ngominhchau24/softmax_proj/docs/figures/smx_exp2.pdf

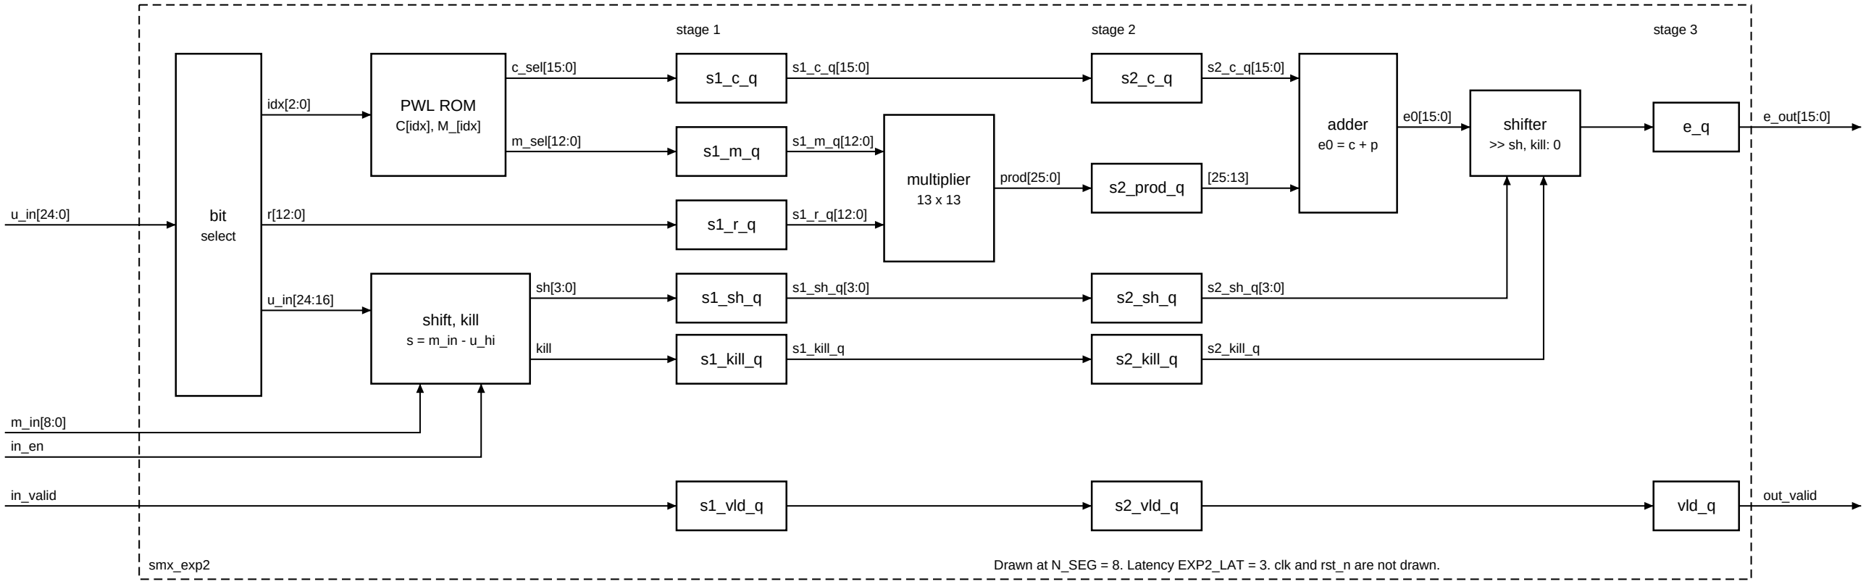
[picture p1: figure]
smx_exp2; stage 1; stage 2; stage 3; bit select; PWL ROM C[idx], M_[idx]; shift, kill s = m_in - u_hi; s1_kill_q; multiplier; s2_prod_q; s2_kill_q; adder e0 = c + p; shifter >> sh, kill: 0; s1_vld_q; s2_vld_q; vld_q; idx[2:0]; c_sel[15:0]; m_sel[12:0]; kill; prod[25:0]; e_out[15:0]; in_valid; out_valid

Drawn at N_SEG = 8. Latency EXP2_LAT = 3. clk and rst_n are not drawn.
