ngominhchau24/softmax_proj/docs/figures/smx_sumacc.pdf

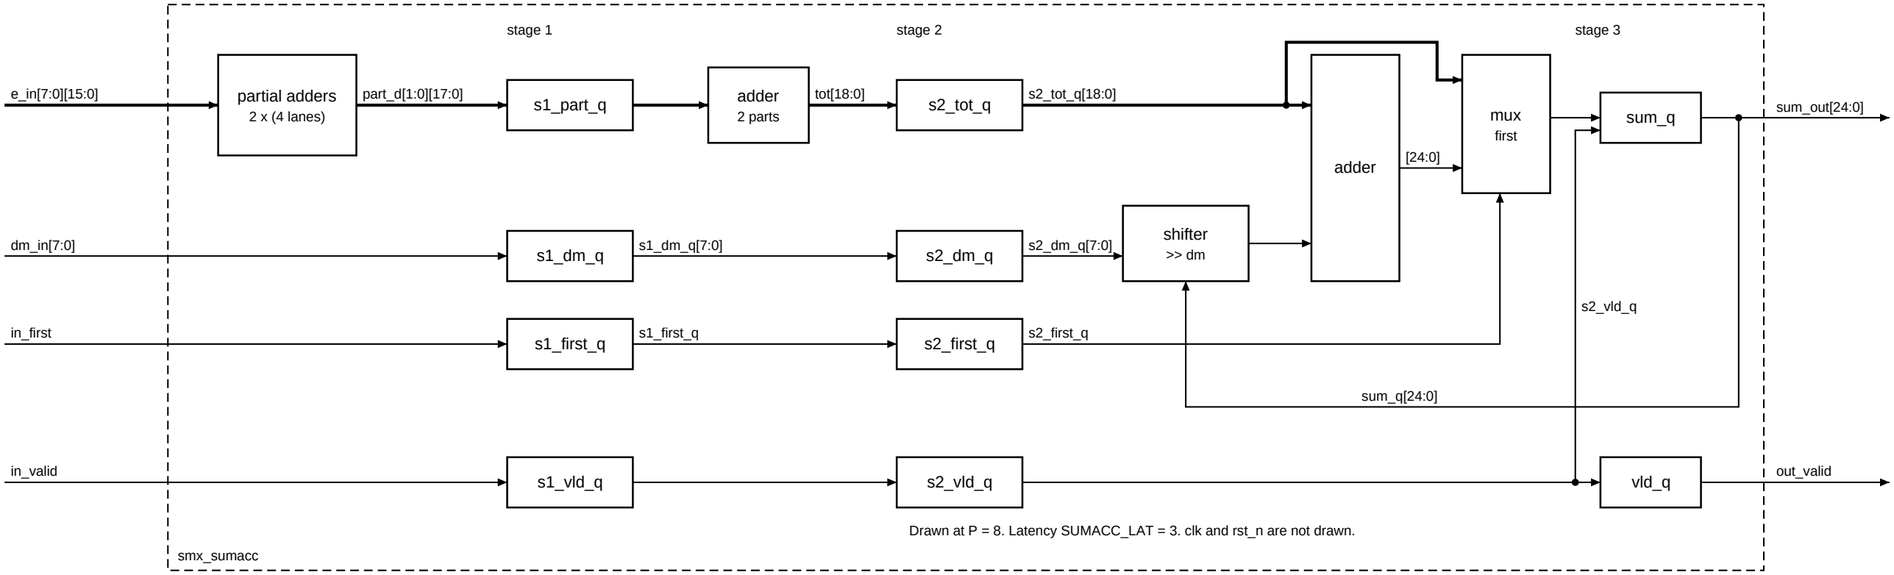
[picture p2: figure]
smx_sumacc; stage 1; stage 2; stage 3; partial adders; 2 x (4 lanes); s1_part_q; s1_first_q; adder; 2 parts; s2_tot_q; s2_first_q; shifter >> dm; mux first; sum_q; s1_vld_q; s2_vld_q; vld_q; part_d[1:0][17:0]; tot[18:0]; in_first; s2_tot_q[18:0]; sum_out[24:0]; sum_q[24:0]; in_valid; out_valid

Drawn at P = 8. Latency SUMACC_LAT = 3. clk and rst_n are not drawn.
