ngominhchau24/softmax_proj/docs/figures/smx_system.pdf

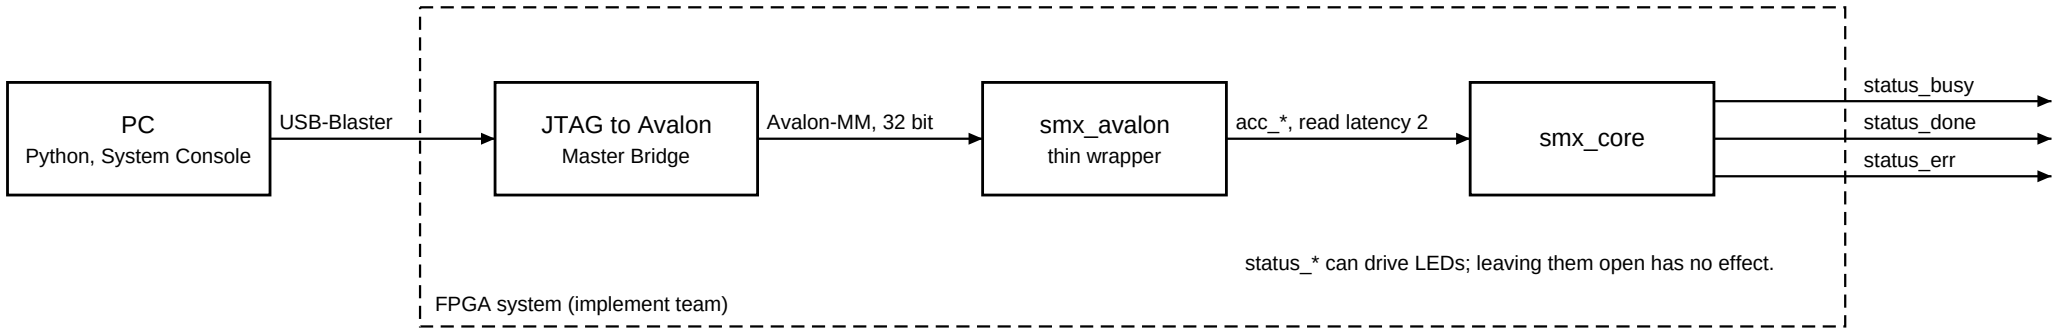
[picture p3: figure]
FPGA system (implement team); PC Python, System Console; JTAG to Avalon Master Bridge; smx_avalon; thin wrapper; smx_core; status_busy; status_done; status_err

USB-Blaster | Avalon-MM, 32 bit | acc_*, read latency 2

status_* can drive LEDs; leaving them open has no effect.
