ngominhchau24/softmax_proj/docs/report/main.tex

% Báo cáo BTL — smx: Integer-Only Softmax Accelerator
% Biên dịch bằng XeLaTeX (hỗ trợ tiếng Việt và font Times New Roman):
%   cd docs/report && xelatex main.tex && xelatex main.tex

\documentclass[12pt,a4paper]{article}

% ---------- Lề trang ----------
\usepackage[left=3cm,right=2cm,top=2.5cm,bottom=2.5cm]{geometry}

% ---------- Font: Times New Roman (fallback Liberation Serif, cùng metric) ----------
\usepackage{fontspec}
\IfFontExistsTF{Times New Roman}
  {\setmainfont{Times New Roman}}
  {\setmainfont{Liberation Serif}}

% ---------- Cỡ chữ 13pt (class article không có sẵn 13pt) ----------
\makeatletter
\renewcommand\normalsize{%
  \@setfontsize\normalsize{13pt}{16pt}%
  \abovedisplayskip=11pt plus 2pt minus 4pt
  \belowdisplayskip=\abovedisplayskip
}
\makeatother
\normalsize

% ---------- Giãn dòng 1.5, đoạn: before 6pt, after 0 ----------
\usepackage{setspace}
\onehalfspacing
\setlength{\parskip}{6pt}
\setlength{\parindent}{1.25cm}

% ---------- Tiện ích ----------
\usepackage{amsmath}
\usepackage{graphicx}
\graphicspath{{../figures/}}
\usepackage{booktabs}
\usepackage{listings}
\lstset{basicstyle=\ttfamily\scriptsize, breaklines=true, breakatwhitespace=true,
        columns=fullflexible, keepspaces=true, frame=single, framesep=4pt,
        xleftmargin=4pt, xrightmargin=4pt, aboveskip=8pt, belowskip=4pt}
% Nhật ký của một testcase: chỉ chèn khi file có trong docs/report/logs/
\newcommand{\smxlog}[2]{\IfFileExists{logs/#1}{\noindent\textit{#2}\lstinputlisting{logs/#1}}{}}
\usepackage{titlesec}
\usepackage{enumitem}
\setlist{itemsep=1pt, parsep=0pt, topsep=3pt, partopsep=0pt}   % danh sách gọn, không cách dòng thừa

% ---------- Hình và bảng trôi ----------
% Cho phép hình, bảng chiếm phần lớn một trang có chữ, để không bị đẩy sang trang riêng gần trống;
% trên trang chỉ có hình thì xếp từ đầu trang xuống, không giãn đều ra cả trang.
\renewcommand{\topfraction}{0.9}
\renewcommand{\bottomfraction}{0.8}
\renewcommand{\textfraction}{0.08}
\renewcommand{\floatpagefraction}{0.8}
\setcounter{topnumber}{3}
\setcounter{bottomnumber}{2}
\setcounter{totalnumber}{4}
\makeatletter
\setlength{\@fptop}{0pt}
\setlength{\@fpsep}{14pt}
\setlength{\@fpbot}{0pt plus 1fil}
\makeatother
\usepackage{hyperref}
\hypersetup{hidelinks}   % liên kết vẫn bấm được, không có khung màu quanh chữ

% ---------- Ngôn ngữ của các nhãn tự sinh ----------
% Báo cáo tiếng Việt: giữ \reportvitrue (Bảng, Hình, Mục lục, Tài liệu tham khảo, Chương).
% Bản tiếng Anh: đổi thành \reportvifalse (Table, Figure, Contents, References, Chapter).
\newif\ifreportvi
\reportvitrue
\ifreportvi
  \renewcommand{\tablename}{Bảng}
  \renewcommand{\figurename}{Hình}
  \renewcommand{\contentsname}{Mục lục}
  \renewcommand{\refname}{Tài liệu tham khảo}
  \newcommand{\smxchaptername}{Chương}
\else
  \newcommand{\smxchaptername}{Chapter}
\fi

% Tiêu đề chương (\section) và mục (\subsection)
\titleformat{\section}
  {\normalfont\bfseries\fontsize{13pt}{16pt}\selectfont\centering}
  {\smxchaptername{} \thesection.}{0.5em}{\MakeUppercase}
\titleformat{\subsection}
  {\normalfont\bfseries\fontsize{13pt}{16pt}\selectfont}
  {\thesubsection}{0.5em}{}
% Mỗi chương bắt đầu ở một trang mới
\newcommand{\sectionbreak}{\clearpage}
\titlespacing*{\section}{0pt}{0pt}{14pt}
\titlespacing*{\subsection}{0pt}{6pt}{0pt}

\begin{document}

% ---------- Trang bìa ----------
\begin{titlepage}
\begin{center}
ĐẠI HỌC QUỐC GIA THÀNH PHỐ HỒ CHÍ MINH\\[0.2em]
\textbf{TRƯỜNG ĐẠI HỌC BÁCH KHOA}\\[2em]
% Logo trường: đặt file docs/figures/logo_bk.png; chưa có file thì trang bìa vẫn biên dịch được
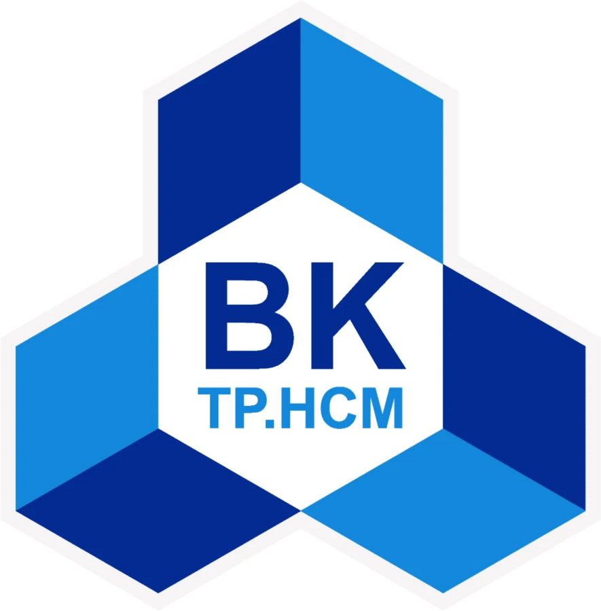
[picture p4: docs/figures/logo_bk.png]
\IfFileExists{../figures/logo_bk.png}{\\[2em]}{\vspace*{3em}}
\textbf{BÁO CÁO BÀI TẬP LỚN}\\[0.3em]
Môn: Cấu trúc phần cứng cho giải thuật học máy\\[2.5em]
\textbf{THIẾT KẾ VÀ HIỆN THỰC FPGA\\BỘ TĂNG TỐC SOFTMAX NGUYÊN THUẦN\\CHO ATTENTION TRANSFORMER}\\[0.3em]
\textit{Design and FPGA Implementation of an\\Integer-Only Softmax Accelerator for Transformer Attention}\\[3em]
Nhóm 6\\[0.6em]
\begin{tabular}{ll}
\toprule
Họ và tên & MSSV \\
\midrule
Ngô Minh Châu     & 2470212 \\
Trần Gia Tuấn     & 2470214 \\
Đặng Phước Tiến   & 2470455 \\
\bottomrule
\end{tabular}\\[2em]
Giảng viên hướng dẫn: PGS.TS. Trương Quang Vinh\\
\vfill
Thành phố Hồ Chí Minh, 2026
\end{center}
\end{titlepage}

% Mục lục: giãn dòng đơn và không cách đoạn, để không tràn trang
{\setlength{\parskip}{0pt}\singlespacing\tableofcontents}
\clearpage

\input{chapters/01-gioi-thieu}
\input{chapters/02-co-so-khao-sat}
\input{chapters/03-dac-ta-so-hoc}
\input{chapters/04-kien-truc}
\input{chapters/05-thiet-ke-khoi}
\input{chapters/06-kiem-thu}
\input{chapters/07-tong-hop-danh-gia}
\input{chapters/08-ket-luan}

\input{chapters/99-tai-lieu-tham-khao}

\end{document}
