ngominhchau24/softmax_proj/docs/spec/07-open-decisions.md

# Open decisions — danh sách để Chau xem

> Ghi trong lúc xây các block còn lại theo ủy quyền của Chau ngày 2026-11-03. Phần A cần Chau quyết. Phần B là việc đã tự quyết để không dừng công việc, đảo ngược được; Chau chỉ cần xem lướt và phản đối nếu không đồng ý.

## A. Cần Chau quyết

- [ ] **A1. Duyệt tài liệu block.** Theo yêu cầu của Chau, RTL được viết trước cổng duyệt. Các block mới không mang trạng thái `APPROVED`; tài liệu ghi "chưa Chau duyệt". Chau đọc rồi xác nhận từng block hoặc yêu cầu sửa.
- [x] **A2. Bộ đồng bộ reset (REQ-IF-04).** Chau chốt 2026-11-05: phần deassert do test drive. Lõi không chứa bộ đồng bộ; bên lái `rst_n` phải thả reset đồng bộ. Mọi testbench trong `tb/` đã thả ở cạnh xuống của `clk`, cách cạnh lên kế tiếp nửa chu kỳ. Khi lõi nằm trong hệ thống thật, phần này thuộc về bên nối `rst_n` (`08-integration-notes.md` mục 2).
- [x] **A3. Sửa câu trong REQ-ARI-05 (requirements đóng băng).** Câu "`sum` không dấu, ≥ 25 bit (≤ 512·2¹⁶)" có cận 2²⁵, cần 26 bit. Cận đúng và đã đo là `L_MAX·2¹⁵ = 2²⁴`, cần 25 bit. Không ảnh hưởng số học hay giao diện. Chau duyệt 2026-11-06; đã sửa `requirements.md` thành "≤ 512·2¹⁵ = 2²⁴", ghi Nhật ký và mục 7.1 của `PROJECT.md`.
- [ ] **A4. Span Platform Designer (bàn giao nhóm implement, chưa kiểm).** Cổng 13 bit word address có thể khiến Platform Designer gán span 0x8000 thay vì 0x6000 trong requirements 5.2. Lõi không bị ảnh hưởng vì vùng `0x1800..0x1FFF` đọc 0. Đề xuất ghi một dòng vào `08-integration-notes.md` để nhóm implement kiểm.

- [ ] **A5. Sideband trong M10K, đường găng nhất ở P = 8.** Quartus tự chuyển `tag_q` và trễ `u` sang `altshift_taps`, tiết kiệm thanh ghi nhưng ngõ ra RAM chậm. Mọi seed vẫn đạt ≥ 100 MHz nên không bắt buộc sửa. So sánh bằng Fitter thật, cùng 3 seed, Fmax lấy góc slow xấu hơn:

  | Cấu hình | Fmax seed 1 / 2 / 3 (MHz) | Thanh ghi | M10K | ALM |
  |---|---|---|---|---|
  | P = 8, hiện tại | 122,09 / 129,87 / 134,41 | ~1 210 | 21 | ~1 035 |
  | P = 8, `AUTO_SHIFT_REGISTER_RECOGNITION OFF` | 124,38 / 139,63 / 128,29 | ~1 810 | 15 | ~1 023 |
  | P = 16, hiện tại | 108,57 / 112,94 / 107,83 | ~2 020 | 33 | ~1 817 |
  | P = 16, `AUTO_SHIFT_REGISTER_RECOGNITION OFF` | 108,93 / 111,31 / 112,93 | ~3 190 | 23 | ~1 795 |

  Chênh lệch nằm trong sai số giữa các seed. Đề xuất giữ nguyên, không thêm attribute: không có lợi Fmax rõ ràng, và đường `s3_c_q` → `smx_maxtree.s1_a_q` vẫn còn đó khi bỏ M10K. Nếu sau này cần thêm biên ở P = 16, chỗ cần sửa là tầng 1 của `smx_maxtree`, không phải sideband.
- [ ] **A6. Giá trị vượt độ rộng trường của LEN, ROWS.** Ghi LEN = 1025 cho `len = 1` (trường [9:0]), ghi ROWS = 33 cho `rows = 1` (trường [4:0]); lần chạy diễn ra bình thường, không có ERR. Đúng theo bản đồ thanh ghi, nhưng phần mềm có thể tưởng ERR bắt được mọi giá trị sai. Đề xuất giữ RTL, ghi một dòng vào `08-integration-notes.md`.
- [ ] **A7. Đường `acc_*` chưa được ràng buộc timing (bàn giao nhóm implement).** SDC của `syn/fit.sh` chỉ có clock, nên Fmax là thanh ghi tới thanh ghi. Đo thử bằng `quartus_sta` với input delay 0, góc slow 0 °C, seed 1: `acc_addr` → thanh ghi còn slack 7,85 / 4,43 / 7,42 ns (P = 4/8/16), đường dài nhất qua decode vào `s1_val_q`, `k_q`; `rd_q` → `acc_readdata` 4,65 / 3,86 / 4,24 ns; recovery của `rst_n` 7,82 / 8,21 / 8,30 ns. Các đường này Fitter không tối ưu, nên số chỉ để tham khảo; nhóm implement sẽ có số thật khi tổng hợp cả hệ thống. Đề xuất ghi vào `08-integration-notes.md`: ở 100 MHz, interconnect còn khoảng 4 ns cho `acc_addr`, và nên ràng buộc đường này khi tổng hợp.

## B. Đã tự quyết (đảo ngược được)

- **B1.** `SUM_W` từ 26 xuống 25. `E ≤ 2¹⁵` nên `sum ≤ L_MAX·2¹⁵ = 2²⁴`; đạt 2²⁴ ở `K = 0, L = 512` [GM]. Requirements chỉ đòi ≥ 25 bit.
- **B2.** Kiểm LEN, ROWS nằm ở `smx_csr`, không có trạng thái CHECK trong FSM. START sai thì BUSY không lên và `CYCLE_CNT = 0`. Sơ đồ FSM trong `04-architecture.md` được cập nhật theo; bảng block ở đó vốn đã ghi việc kiểm thuộc `smx_csr`.
- **B3.** Khi BUSY, ghi LEN, ROWS, SCALE_K, X_BUF bị bỏ qua. REQ-IF-09 để không xác định nên được phép chọn.
- **B4.** `smx_buf` có `BANKS = P/4` để quét được P = 4/8/16 (A5). P = 8 đúng bằng A1.
- **B5.** Latency chốt ở `smx_pkg`, `T_row = 2G + 54`, `CYCLE_CNT = R·(2G + 54) + 1`. Là số thiết kế; xác nhận bằng mô phỏng ở bước tích hợp.
- **B6.** `model/softmax_ref.py` thêm trường trung gian vào `info` và tách `group_sum`, `reciprocal`, `norm_out`. Không đổi số học: 6000 hàng ngẫu nhiên và corner ở P, N_SEG = 4/8/16 cho kết quả trùng bản cũ.
- **B7.** Bộ chia dùng so sánh 25 bit và 27 vòng lặp, thay vì ~41 bit như bảng ước lượng trong `04-architecture.md`. Kết quả vẫn bit-exact vì `2¹⁴ ≤ sum ≤ 2²⁴`.
- **B8.** Chia tầng `smx_maxtree` để tầng 2 chứa mức cuối của cây, so với M và `dm`. Kết quả từ Fitter trên probe: gom cả cây vào tầng 1 chỉ đạt 90 MHz ở P = 16.
- **B9.** `smx_delay` không có tài liệu block và testbench riêng vì chỉ vài dòng; kiểm qua testbench `smx_core`.
- **B10.** Dạng assertion REQ-VER-03 cho nhóm verify: `$rose(done) |-> !busy`, không phải `|-> $fell(busy)`; assertion "không có X trên `readdata`" chỉ áp dụng cho vị trí đã ghi (`05-cross-block.md` mục 4.8).
- **B11.** `tb_smx_core` có một bộ đếm thụ động nhìn vào `dut.u_ybuf.wr_en`, ngoại lệ duy nhất với nguyên tắc chỉ dùng `acc_*`. Lý do: START ngay chu kỳ DONE cùng cấu hình cho Y giống hệt, nên mất ghi không thể thấy qua bus.
