ngominhchau24/softmax_proj/docs/report/chapters/04-kien-truc.tex

\section{Kiến trúc hệ thống}

\subsection{Sơ đồ tổng thể}

Bộ tăng tốc gồm một lõi \texttt{smx\_core} và một lớp bao Avalon-MM mỏng. Lõi chứa toàn bộ thanh ghi điều khiển, bộ đệm đầu vào X, bộ đệm đầu ra Y, bộ điều khiển và datapath. Lõi đưa ra một cổng truy cập bộ nhớ đơn giản \texttt{acc\_*}, có độ trễ đọc cố định 2 chu kỳ và không có tín hiệu chờ. Ranh giới này trong hệ thống demo đã được vẽ ở Hình \ref{fig:smx-system} của Chương 1: máy tính điều khiển qua USB-Blaster, cầu JTAG to Avalon Master, lớp bao rồi tới lõi.

Hình \ref{fig:softmax-flow} tóm tắt đường đi của dữ liệu qua các phép tính của Chương 3. Luồng dữ liệu của một hàng:
\begin{enumerate}
  \item Lượt 1 đọc $X$ theo nhóm $P$ phần tử, đưa qua phép nhân với $K$, IntMax, $E(d)$ và cây cộng để có $\mathit{sum}$ và $M$.
  \item Bộ chia tính $\mathit{Rcp}$ từ $\mathit{sum}$.
  \item Lượt 2 đọc lại $X$, tính lại $E$, nhân với $\mathit{Rcp}$, làm tròn, bão hoà và ghi vào $Y$.
\end{enumerate}

\begin{figure}[htbp]
  \centering
  
  \caption{Luồng số học của một hàng. Lượt 1 đi qua nhánh $M$, $dM$ và bộ tích luỹ $\mathit{sum}$ để có $\mathit{Rcp}$; lượt 2 dùng lại nhánh $E$ rồi nhân với $\mathit{Rcp}$ để ra $y$.}
  \label{fig:softmax-flow}
\end{figure}

\subsection{Cấu trúc bên trong lõi}

Hình \ref{fig:smx-core} là sơ đồ khối của \texttt{smx\_core}, vẽ ở $P = 8$ và $N_{\text{SEG}} = 8$. Khối \texttt{smx\_csr} giải mã cổng \texttt{acc\_*}, giữ các thanh ghi và ghi vào X\_BUF. Khi chạy, \texttt{smx\_ctrl} phát địa chỉ từng nhóm; dữ liệu đọc từ X\_BUF đi qua \texttt{smx\_scale}, \texttt{smx\_maxtree} và \texttt{smx\_exp2}, rồi rẽ sang \texttt{smx\_sumacc} và \texttt{smx\_divider} ở lượt 1, hoặc sang \texttt{smx\_norm} và Y\_BUF ở lượt 2. Một chuỗi thanh ghi dịch mang các nhãn của nhóm (lượt, nhóm đầu, nhóm cuối, mặt nạ lane) đi song song với dữ liệu, nên mỗi khối biết nhóm nó đang xử lý mà không cần tự đếm.

\begin{figure}[p]
  \centering
  
  \caption{Sơ đồ khối bên trong \texttt{smx\_core} (xoay ngang), vẽ ở $P = 8$, $N_{\text{SEG}} = 8$; clock và reset không vẽ.}
  \label{fig:smx-core}
\end{figure}

\subsection{Điều khiển}

Khối \texttt{smx\_ctrl} đi theo máy trạng thái ở Hình \ref{fig:smx-fsm}, gồm tám trạng thái. Từ \texttt{IDLE}, lệnh START đưa lõi vào \texttt{P1\_RUN}, nơi mỗi chu kỳ phát một nhóm của lượt 1; \texttt{P1\_DRAIN} chờ tổng của nhóm cuối ra khỏi pipeline. \texttt{DIV} khởi động bộ chia và \texttt{DIV\_WAIT} chờ nó xong. \texttt{P2\_RUN} và \texttt{P2\_DRAIN} làm tương tự cho lượt 2, tới khi phần tử $y$ cuối cùng được ghi. \texttt{NEXT\_ROW} hoặc quay lại \texttt{P1\_RUN} cho hàng kế tiếp, hoặc báo xong và về \texttt{IDLE}. Việc chuyển pha dựa trên sự kiện từ datapath, không dựa trên bộ đếm độ trễ.

\begin{figure}[htbp]
  \centering
  
  \caption{Máy trạng thái của \texttt{smx\_ctrl}. Nhãn trên mỗi cung là điều kiện chuyển; $r$ là chỉ số hàng, $R$ là số hàng.}
  \label{fig:smx-fsm}
\end{figure}

\subsection{Giao diện}

IP là một Avalon-MM slave với dữ liệu 32 bit và địa chỉ theo word. Giao diện không dùng burst, không dùng \texttt{waitrequest}, và có độ trễ đọc 2 chu kỳ. Phần mềm thăm dò bit \texttt{DONE} để biết khi nào xong; IP không phát ngắt. Ba tín hiệu trạng thái \texttt{status\_busy}, \texttt{status\_done} và \texttt{status\_err} được đưa ra ngoài qua một conduit để nối LED khi demo.

Hai kiểu hệ thống được hỗ trợ:
\begin{itemize}
  \item Đường demo chính: không dùng HPS, master là JTAG to Avalon Master Bridge, điều khiển từ PC bằng System Console.
  \item Đường tuỳ chọn: GHRD Terasic, master là cầu HPS-to-FPGA.
\end{itemize}

\subsection{Lớp bao Avalon và hệ thống demo}

Lớp bao \texttt{smx\_avalon} chỉ đổi tên tín hiệu giữa Avalon-MM slave \texttt{s0} và cổng \texttt{acc\_*} của lõi, không thêm logic nào. Thành phần Platform Designer được khai báo trong \texttt{ip/smx\_hw.tcl} với các giao diện: clock, reset mức thấp, slave \texttt{s0} (địa chỉ theo word, độ trễ đọc 2, không \texttt{waitrequest}, không burst, \texttt{byteenable} 4 bit) và conduit trạng thái. Hai tham số $P$ và $N_{\text{SEG}}$ chọn được khi tạo thành phần.

Hệ thống demo trên DE10-Standard không dùng HPS và gồm ba khối: nguồn clock 50 MHz từ \texttt{CLOCK\_50}, JTAG to Avalon Master Bridge, và \texttt{smx} đặt ở địa chỉ gốc 0, nên offset dùng trong System Console trùng với offset của bản đồ thanh ghi. Ở mức top, nút \texttt{KEY[0]} là reset mức thấp, đi qua một bộ đồng bộ hai tầng để được thả đồng bộ với clock, vì lõi không có bộ đồng bộ reset riêng; ba đèn \texttt{LEDR[2:0]} hiển thị BUSY, DONE và ERR.

Tại thời điểm viết báo cáo, lớp bao, thành phần và hệ thống demo đã được nhóm hiện thực viết và biên dịch thành công bằng Quartus, tạo được tệp \texttt{.sof}. Thiết kế chưa được nạp lên board, và phần gán chân chưa được đối chiếu với tài liệu của Terasic.

\subsection{Bản đồ thanh ghi}

Bảng \ref{tab:regmap} tóm tắt bản đồ thanh ghi, offset tính theo byte.

\begin{table}[htbp]
\centering
\small
\begin{tabular}{lllp{7.2cm}}
\toprule
Offset & Tên & Truy cập & Nội dung \\
\midrule
0x0000 & CTRL      & W   & Bit 0: START (tự xoá) \\
0x0004 & STATUS    & R   & BUSY, DONE, ERR \\
0x0008 & LEN       & R/W & Độ dài hàng $L$, 1..512 \\
0x000C & ROWS      & R/W & Số hàng $R$, 1..16 \\
0x0010 & SCALE\_K  & R/W & Hệ số $K$ (UQ0.16) \\
0x0014 & CYCLE\_CNT & R  & Số chu kỳ từ START đến DONE \\
0x0018 & HW\_PARAM & R   & $P$, $\log_2 L_{\max}$, $R_{\max}$, $\log_2 N_{\text{SEG}}$, VERSION \\
0x2000--0x3FFF & X\_BUF & R/W & INT8, hàng $r$ phần tử $i$ tại byte $r \cdot 512 + i$ \\
0x4000--0x5FFF & Y\_BUF & R   & UINT8, cùng bố trí \\
\bottomrule
\end{tabular}
\caption{Bản đồ thanh ghi của IP (rút gọn từ đặc tả).}
\label{tab:regmap}
\end{table}

\subsection{Trình tự phần mềm}

Phần mềm thực hiện lần lượt các bước sau: tính $K$ và ghi vào \texttt{SCALE\_K}; ghi $R$ hàng vào X\_BUF; ghi \texttt{LEN} và \texttt{ROWS}; ghi START; đọc STATUS cho đến khi DONE bằng 1; đọc Y\_BUF, và đọc CYCLE\_CNT nếu cần đo thời gian.
