ngominhchau24/softmax_proj/docs/report/chapters/05-thiet-ke-khoi.tex

\section{Thiết kế các khối}

Lõi được chia thành mười khối, thiết kế theo thứ tự phụ thuộc. Mỗi khối có một tài liệu thiết kế riêng, mô tả chức năng, bảng cổng, số học đối chiếu với golden model, sơ đồ cấu trúc, timing và kế hoạch kiểm thử. Trạng thái tại thời điểm viết báo cáo được tóm tắt trong Bảng \ref{tab:blocks}: cả mười khối đã có RTL và testbench tự kiểm, chín khối con đã được tích hợp vào \texttt{smx\_core}.

\begin{table}[htbp]
\centering
\begin{tabular}{clll}
\toprule
\# & Khối & Vai trò & Trạng thái \\
\midrule
1  & \texttt{smx\_exp2}    & $d \to E$, PWL và dịch & Đã tích hợp \\
2  & \texttt{smx\_scale}   & $u = q \cdot K$, $c = \lceil u \rceil$ & Đã tích hợp \\
3  & \texttt{smx\_maxtree} & $M_g$ và cập nhật $M$ & Đã tích hợp \\
4  & \texttt{smx\_sumacc}  & Cây cộng và tích luỹ có dịch & Đã tích hợp \\
5  & \texttt{smx\_divider} & $\lfloor 2^{40} / \mathit{sum} \rfloor$ tuần tự & Đã tích hợp \\
6  & \texttt{smx\_norm}    & $E \cdot \mathit{Rcp}$, làm tròn, bão hoà & Đã tích hợp \\
7  & \texttt{smx\_buf}     & Bộ đệm nhiều bank, có byte-enable & Đã tích hợp \\
8  & \texttt{smx\_csr}     & Thanh ghi, START/DONE/ERR & Đã tích hợp \\
9  & \texttt{smx\_ctrl}    & FSM hàng và lượt & Đã tích hợp \\
10 & \texttt{smx\_core}    & Nối các khối & Mô phỏng đạt \\
\bottomrule
\end{tabular}
\caption{Danh sách khối và trạng thái thiết kế.}
\label{tab:blocks}
\end{table}

\subsection{Khối số học}

Mỗi khối số học là một pipeline có độ trễ cố định. Các khối \texttt{smx\_scale}, \texttt{smx\_exp2} và \texttt{smx\_norm} xử lý một lane và được nhân bản $P$ lần; \texttt{smx\_maxtree}, \texttt{smx\_sumacc} và \texttt{smx\_divider} mỗi khối chỉ có một bản. Ba khối mang ý tưởng chính của thuật toán được vẽ chi tiết ở các Hình \ref{fig:blk-maxtree}, \ref{fig:blk-exp2} và \ref{fig:blk-sumacc}; trong hình, mọi thanh ghi có hậu tố \texttt{\_q}.

Khối \texttt{smx\_scale} nhân $q$ với $K$ bằng một bộ nhân $8 \times 17$ có dấu để có $u$, rồi làm tròn lên để có $c$; độ trễ 3 chu kỳ. Khối \texttt{smx\_maxtree} thực hiện IntMax: nó che các lane nằm ngoài độ dài hàng, tìm giá trị lớn nhất của nhóm, rồi cập nhật $M$ và bước nhảy $dM$. Khối \texttt{smx\_exp2} là khối phức tạp nhất về số học, vì phải khớp bit-exact với bảng PWL và phép dịch. Khối \texttt{smx\_sumacc} cộng $E$ của các lane rồi tích luỹ vào $\mathit{sum}$; vòng phản hồi qua $\mathit{sum}$ là điểm được dự đoán sẽ găng về timing khi thiết kế kiến trúc, nhưng kết quả đo ở Chương 7 cho thấy với $P = 8$ và $P = 16$ đường găng nhất lại nằm ở tầng đầu của cây max trong \texttt{smx\_maxtree}.

Khối \texttt{smx\_divider} là bộ chia phục hồi radix-2, mỗi chu kỳ quyết định một bit thương và mất 28 chu kỳ cho mỗi hàng. Khối \texttt{smx\_norm} nhân $E$ với $\mathit{Rcp}$ bằng một bộ nhân $16 \times 27$, làm tròn ở bit 31 và bão hoà về 255; độ trễ 3 chu kỳ.

\begin{figure}[htbp]
  \centering
  
  \caption{\texttt{smx\_maxtree}: che các lane ngoài độ dài hàng, tìm giá trị lớn nhất của nhóm bằng cây so sánh, rồi cập nhật $M$ và bước nhảy $dM$. Độ trễ 2 chu kỳ; vẽ ở $P = 8$.}
  \label{fig:blk-maxtree}
\end{figure}

\begin{figure}[htbp]
  \centering
  
  \caption{\texttt{smx\_exp2}: tính $E = 2^{d}$ với $d = u - M \cdot 2^{16}$. Phần lẻ chọn hệ số trong bảng PWL và qua bộ nhân $13 \times 13$; phần nguyên thành lượng dịch phải, hoặc ép kết quả về 0. Độ trễ 3 chu kỳ; vẽ ở $N_{\text{SEG}} = 8$.}
  \label{fig:blk-exp2}
\end{figure}

\begin{figure}[htbp]
  \centering
  
  \caption{\texttt{smx\_sumacc}: cộng $E$ của $P$ lane bằng cây cộng hai tầng, rồi tích luỹ vào $\mathit{sum}$ sau khi dịch tổng cũ sang phải $dM$ bit; nhóm đầu của hàng bỏ qua tổng cũ. Độ trễ 3 chu kỳ; vẽ ở $P = 8$.}
  \label{fig:blk-sumacc}
\end{figure}

\subsection{Khối lưu trữ và điều khiển}

Hai bộ đệm X và Y dùng chung một module \texttt{smx\_buf}, là bộ nhớ hai cổng đơn có cổng đọc qua thanh ghi. Số bank bằng $P/4$, mỗi bank rộng 32 bit; với $P = 8$, mỗi bộ đệm gồm hai bank 32 bit $\times$ 1024 word, và mỗi byte của mỗi bank là một RAM riêng để ghi theo \texttt{byteenable}. Khối \texttt{smx\_csr} giải mã cổng \texttt{acc\_*}, giữ các thanh ghi điều khiển và trạng thái, và ghép đường đọc có độ trễ 2 chu kỳ. Khối \texttt{smx\_ctrl} điều khiển thứ tự hàng, lượt, địa chỉ và mặt nạ lane cho nhóm cuối của mỗi hàng; máy trạng thái của nó đã được mô tả ở Chương 4.

\subsection{Độ trễ và tài nguyên từng khối}

Bảng \ref{tab:blk-res} ghi độ trễ của từng khối và tài nguyên khi tổng hợp riêng khối đó. Các số tài nguyên lấy từ bước Analysis \& Synthesis của Quartus, chưa qua Fitter, nên chỉ dùng để so sánh tương đối giữa các khối; tài nguyên của cả lõi sau Fitter nằm ở Chương 7. Tổng độ trễ của đường từ địa chỉ đọc X\_BUF tới $E$ là $1 + 3 + 2 + 3 = 9$ chu kỳ, và mỗi lượt quét cộng thêm 3 chu kỳ của \texttt{smx\_sumacc} hoặc \texttt{smx\_norm}.

\begin{table}[htbp]
\centering
\small
\begin{tabular}{llrrrl}
\toprule
Khối & Tổng hợp ở & Độ trễ & ALUT & Thanh ghi & Khác \\
\midrule
\texttt{smx\_scale}   & 1 lane  & 3  & 13  & 85  & 1 DSP \\
\texttt{smx\_maxtree} & $P = 8$ & 2  & 202 & 38  & \\
\texttt{smx\_exp2}    & 1 lane  & 3  & [Chưa đo] & [Chưa đo] & 1 DSP \\
\texttt{smx\_sumacc}  & $P = 8$ & 3  & 180 & 101 & \\
\texttt{smx\_divider} &         & 28 & 60  & 109 & \\
\texttt{smx\_norm}    & 1 lane  & 3  & 20  & 66  & 1 DSP \\
\texttt{smx\_buf}     & $P = 8$ & 1  &     & 0   & 65\,536 bit bộ nhớ khối \\
\texttt{smx\_csr}     & $P = 8$ & 2  & 192 & 136 & độ trễ của đường đọc \\
\texttt{smx\_ctrl}    & $P = 8$ &    & 72  & 24  & ngõ ra tổ hợp \\
\bottomrule
\end{tabular}
\caption{Độ trễ (chu kỳ) và tài nguyên của từng khối sau Analysis \& Synthesis. Ô trống: không áp dụng.}
\label{tab:blk-res}
\end{table}

\subsection{Kết quả thiết kế}

Mỗi khối có testbench tự kiểm, so kết quả bit-exact với vector sinh từ golden model, và đều đạt ở các giá trị $P$ và $N_{\text{SEG}}$ mà khối phụ thuộc. Lõi \texttt{smx\_core} sau tích hợp được kiểm qua cổng \texttt{acc\_*}; kết quả kiểm thử được trình bày ở Chương 6, tài nguyên và tần số sau Fitter ở Chương 7.
