ngominhchau24/softmax_proj/docs/figures/sweep_p.pdf

## Tài nguyên logic

## Fmax theo từng seed (MHz)

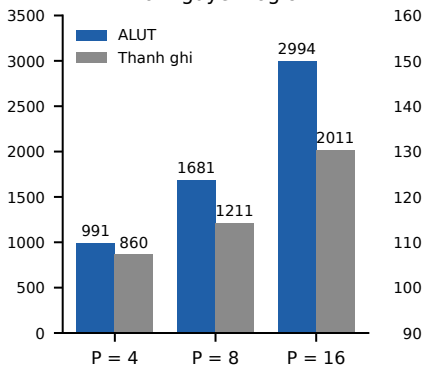
[picture p12: figure]
ALUT Thanh ghi
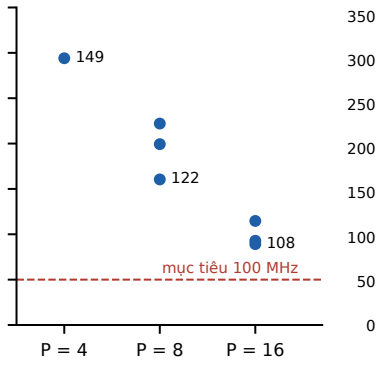
[picture p13: figure]
108 mục tiêu 100 MHz

P = 4 | P = 8 | P = 16

310

182

118

## Chu kỳ mỗi hàng, L = 512
