ngominhchau24/softmax_proj/docs/figures/softmax_flow.pdf

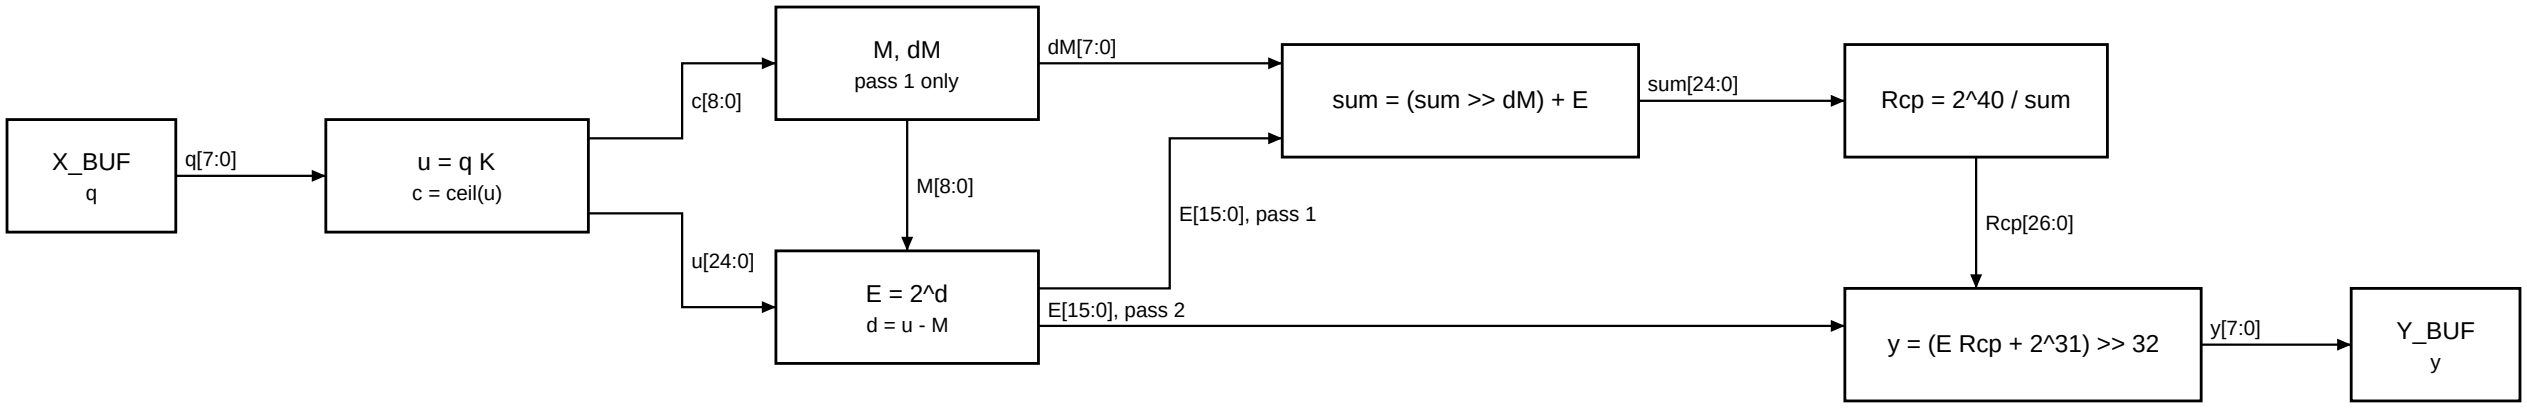
[picture p14: figure]
X_BUF q; u = q K c = ceil(u); M, dM pass 1 only; sum = (sum >> dM) + E; Rcp = 2^40 / sum; y = (E Rcp + 2^31) >> 32; Y_BUF y; E[15:0], pass 1; sum[24:0]; Rcp[26:0]; E[15:0], pass 2
