ngominhchau24/softmax_proj/docs/figures/dv_latency_cycle_cnt.pdf

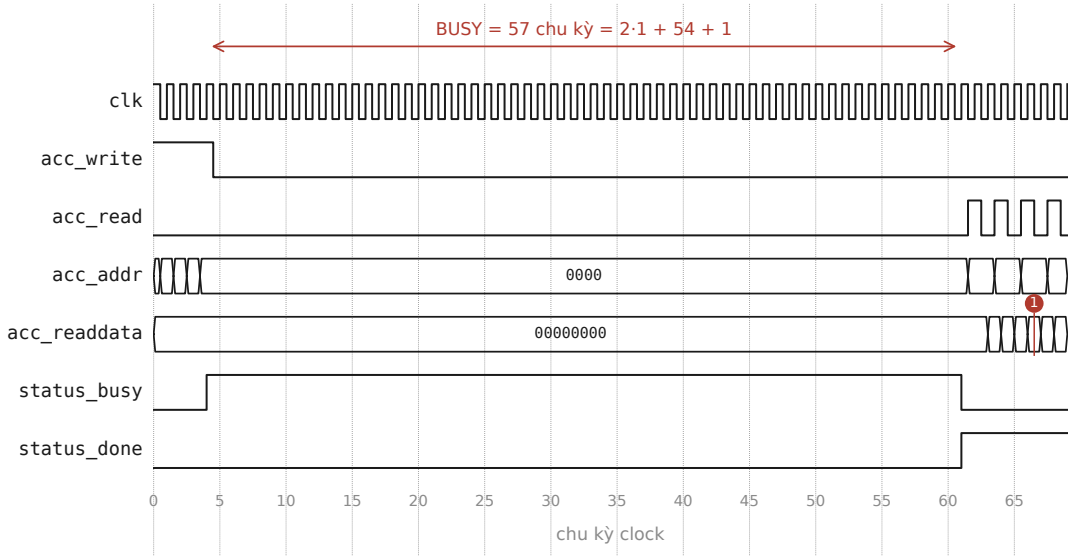
[picture p15: figure]
clk; acc_write; acc_read; acc_addr; acc_readdata; status_busy; status_done; chu kỳ clock; BUSY = 57 chu kỳ = 2·1 + 54 + 1
