ngominhchau24/softmax_proj/docs/figures/dv_proto_err.pdf

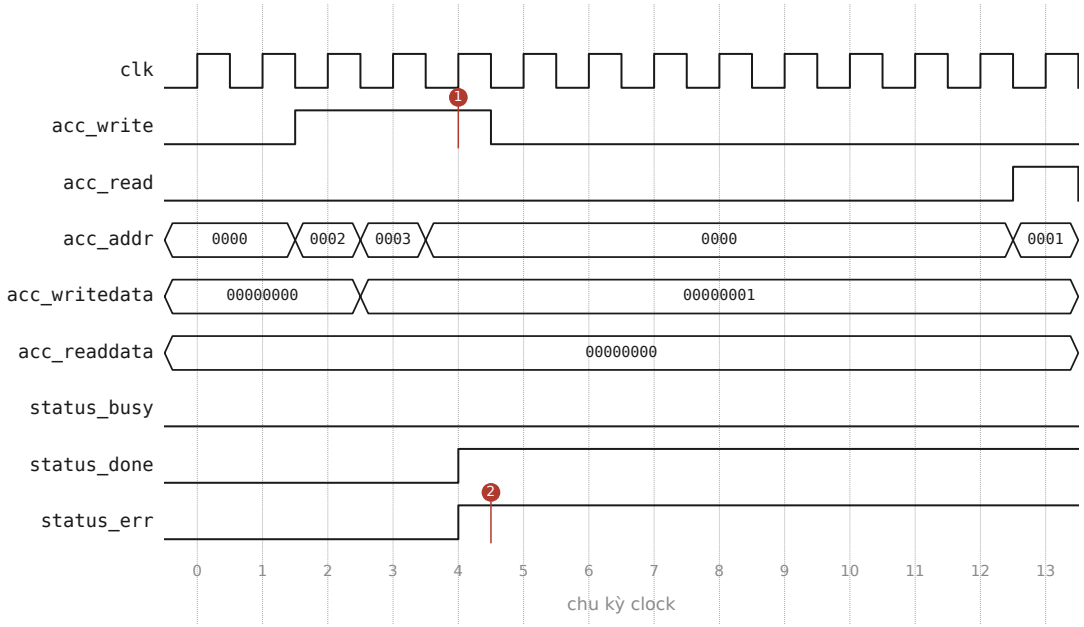
[picture p16: figure]
clk; acc_write; acc_read; acc_addr; acc_writedata; acc_readdata; status_busy; status_done; status_err; chu kỳ clock
