ngominhchau24/softmax_proj/docs/figures/dv_proto_start_busy.pdf

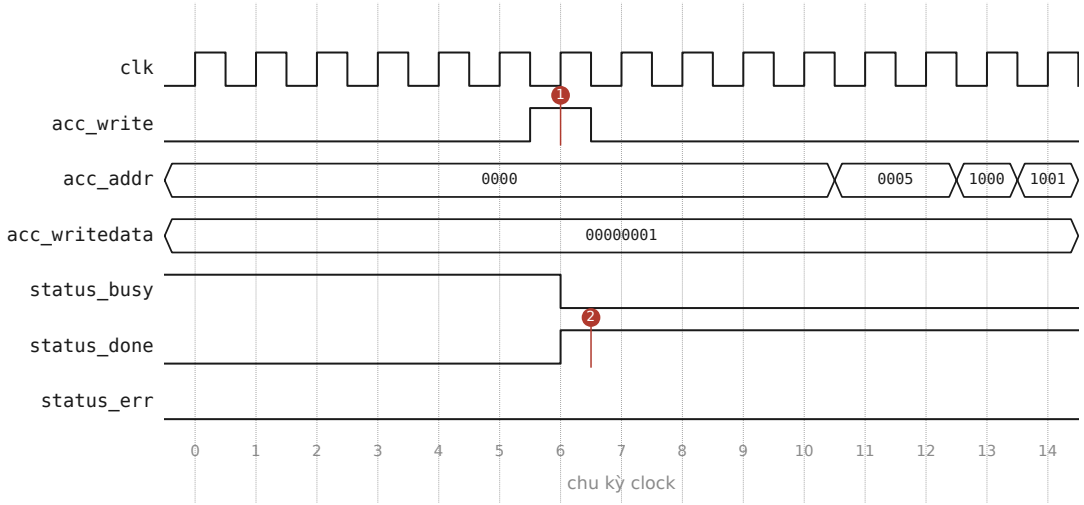
[picture p17: figure]
clk; acc_write; acc_addr; acc_writedata; status_busy; status_done; status_err; chu kỳ clock
