ngominhchau24/softmax_proj/docs/figures/dv_random_reset.pdf

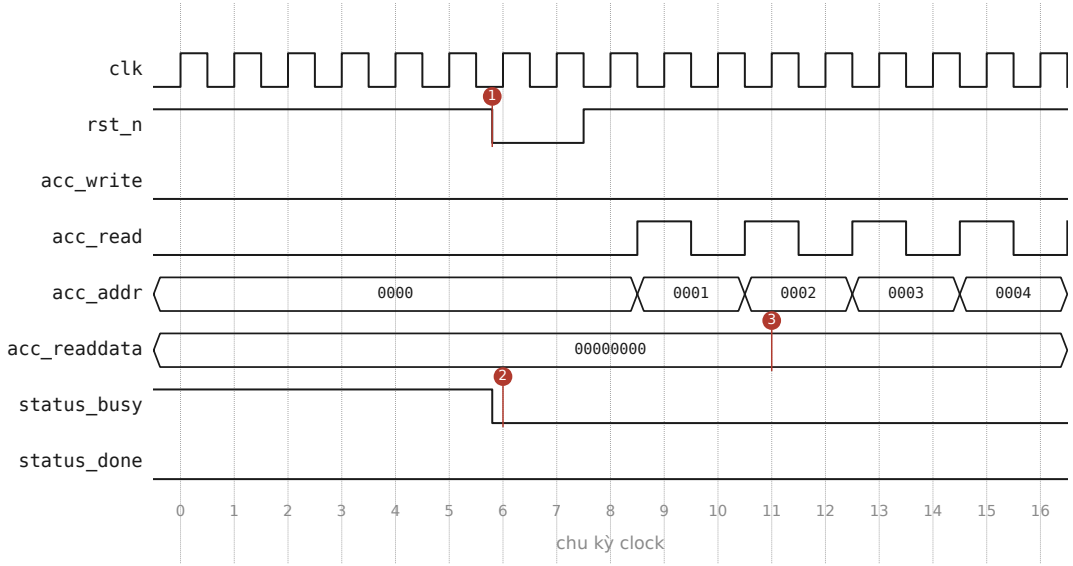
[picture p18: figure]
clk; rst_n; acc_write; acc_read; acc_addr; acc_readdata; status_busy; status_done; chu kỳ clock
