ngominhchau24/softmax_proj/docs/figures/smx_maxtree.pdf

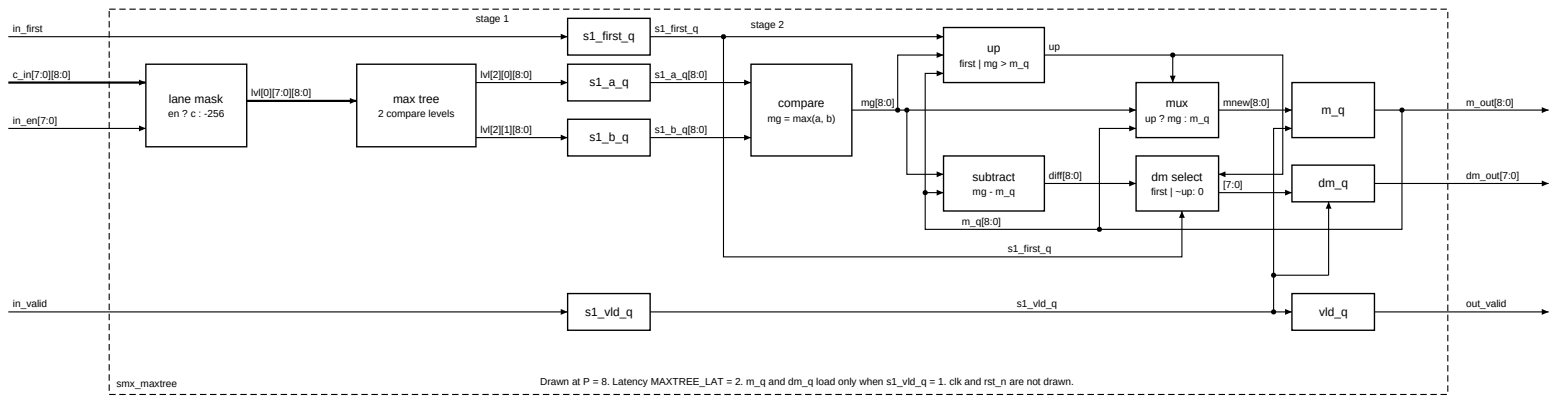
[picture p19: page 1]
smx_maxtree; stage 1; stage 2; lane mask en ? c : -256; max tree 2 compare levels; s1_first_q; compare mg = max(a, b); up first | mg > m_q; subtract mg - m_q; mux up ? mg : m_q; dm select first | ~up: 0; s1_vld_q; vld_q; in_first; lvl[0][7:0][8:0]; lvl[2][0][8:0]; lvl[2][1][8:0]; diff[8:0]; mnew[8:0]; m_out[8:0]; dm_out[7:0]; in_valid; out_valid

Drawn at P = 8. Latency MAXTREE_LAT = 2. m_q and dm_q load only when s1_vld_q = 1. clk and rst_n are not drawn.
