ngominhchau24/softmax_proj/docs/figures/smx_core.pdf

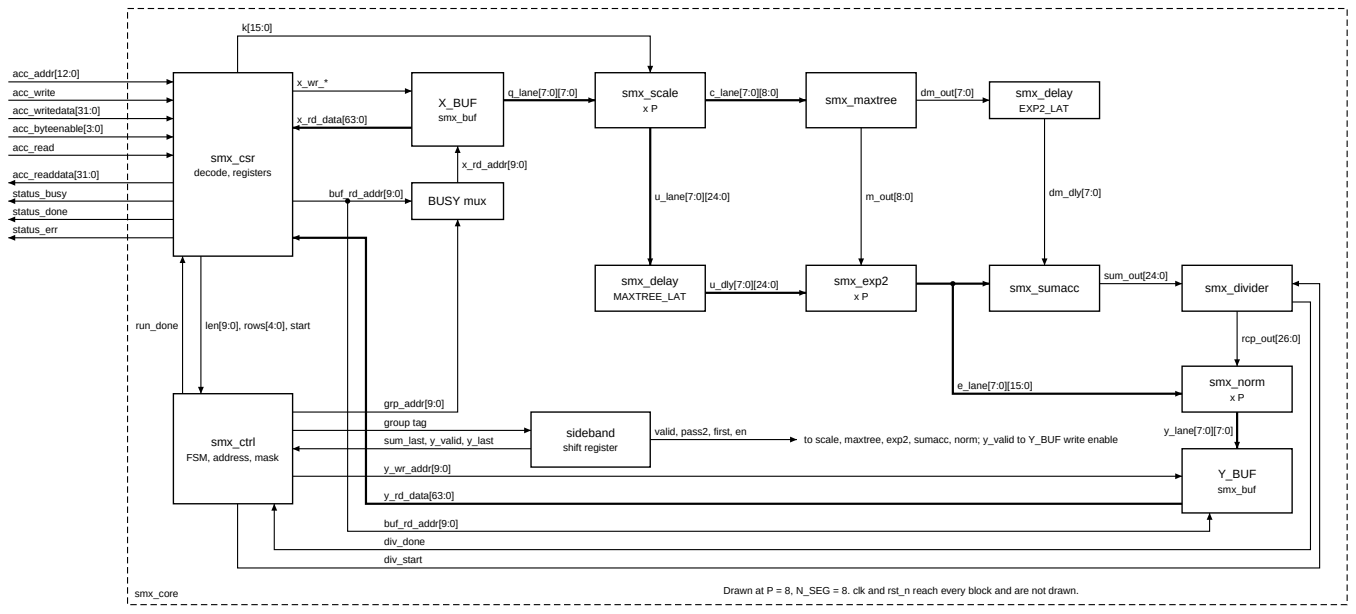
[picture p20: page 1]
smx_core; smx_csr decode, registers; X_BUF smx_buf; BUSY mux; smx_scale x P; smx_delay MAXTREE_LAT; smx_maxtree; smx_exp2 x P; smx_delay EXP2_LAT; smx_sumacc; smx_divider; smx_norm x P; Y_BUF smx_buf; sideband shift register; acc_addr[12:0]; acc_write; acc_writedata[31:0]; acc_byteenable[3:0]; acc_read; acc_readdata[31:0]; status_busy; status_done; status_err; run_done; len[9:0], rows[4:0], start; x_rd_data[63:0]; buf_rd_addr[9:0]; x_rd_addr[9:0]; grp_addr[9:0]; y_rd_data[63:0]; y_wr_addr[9:0]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

smx_ctrl
FSM, address, mask

Drawn at P = 8, N_SEG = 8. clk and rst_n reach every block and are not drawn.
