ngominhchau24/softmax_proj/docs/figures/dv_reg_byteenable.pdf

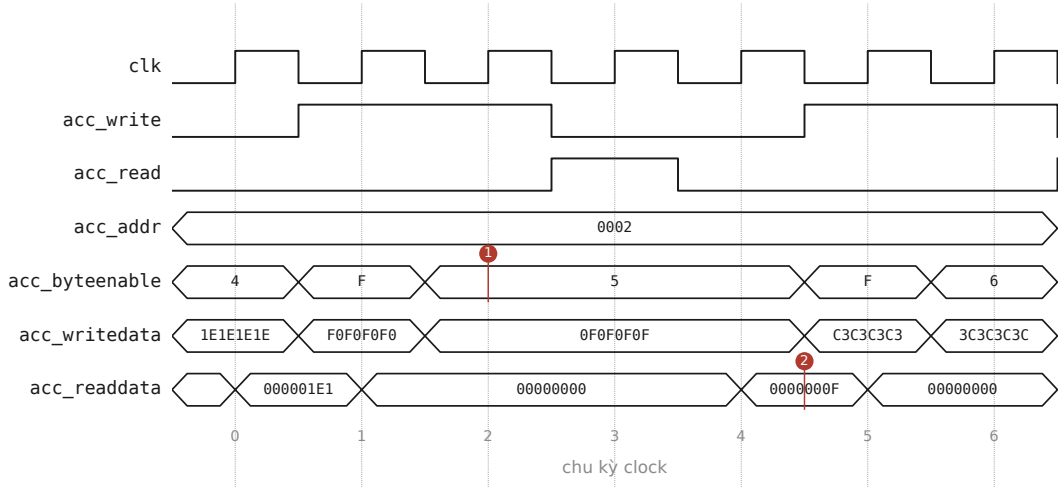
[picture p21: page 1]
clk; acc_write; acc_read; acc_addr; acc_byteenable; acc_writedata; acc_readdata

chu kỳ clock
