ngominhchau24/softmax_proj/docs/figures/dv_sanity_run.pdf

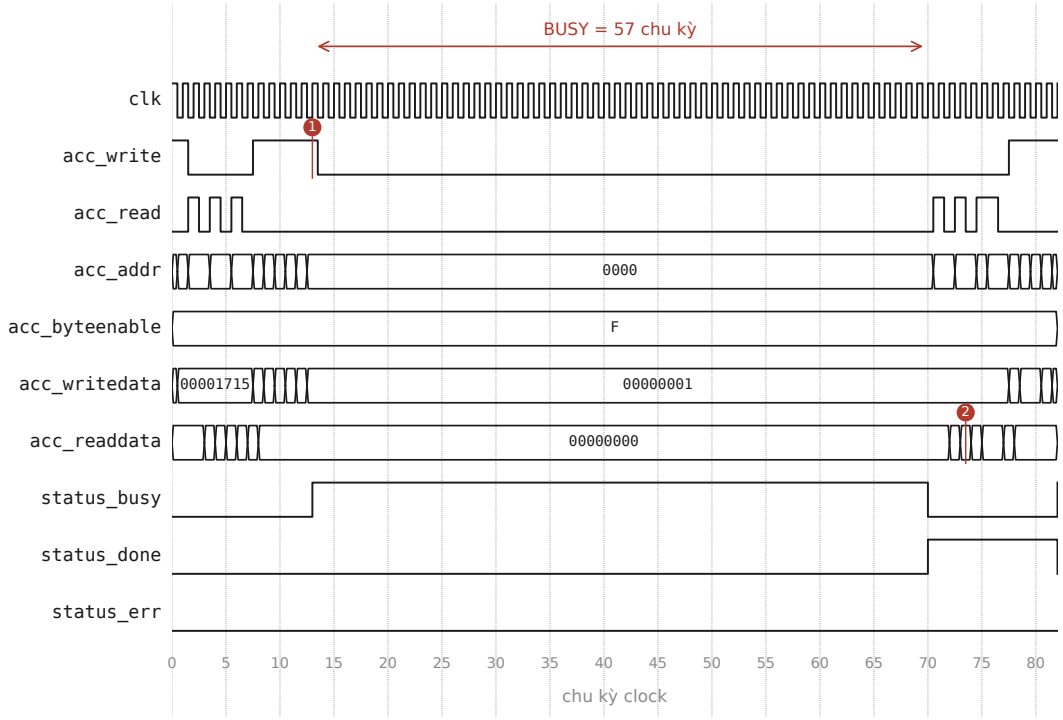
[picture p22: page 1]
clk; acc_write; acc_read; acc_addr; acc_byteenable; acc_writedata; acc_readdata; status_busy; status_done; status_err

BUSY = 57 chu kỳ

chu kỳ clock
