ngominhchau24/softmax_proj/docs/figures/dv_ver02_tail.pdf

# clk

# acc_write

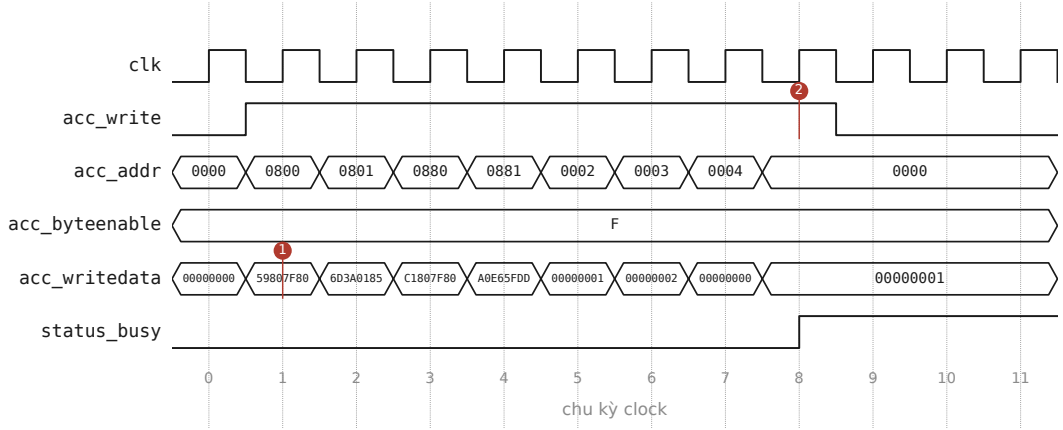
[picture p23: page 1]
acc_addr; acc_byteenable; acc_writedata 00000000; A0E65FDD; status_busy

chu kỳ clock
