ngominhchau24/softmax_proj/(commit log)

2026-10-31 Add smx_exp2 block design doc (APPROVED)
    One-lane E = 2^(d/2^16) unit: 3-stage pipeline (EXP2_LAT = 3), M same
    cycle as u, lane mask inside the block, N_SEG parameterised 4/8/16.
    Arithmetic checked against the golden model; SV constructs checked with
    Quartus 18.1 Lite Analysis & Synthesis. Open questions Q1-Q8 resolved.
2026-10-31 Add smx_exp2 RTL, testbench and vector generator
    - rtl/core/smx_exp2.sv: 3-stage pipeline, bit-exact with exp2_neg()
    - rtl/pkg/smx_pkg.sv: EXP2_LAT, generated PWL tables for N_SEG = 4/16
    - model/gen_vectors.py: T1-T4 vectors from softmax_ref (no new arithmetic)
    - tb/tb_smx_exp2.sv: self-checking, exact-latency check, reset mid-stream
    - tb/run_smx_exp2.sh, syn/map_check.sh: run sim / quartus_map sweeps
    Not yet compiled or simulated.
    [smx_exp2.sv, smx_pkg.sv, tb_smx_exp2.sv]
2026-11-03 Add sim/ flow from risc_v, mark smx_exp2 UT-PASS
    - sim/: Makefile and compile.f = rtl.f + tb.f + testcase.f, organised like
    risc_v milestone3/10_sim. make fails unless the log has TB_RESULT: PASS,
    waves are only logged with WAVE=1, vectors are generated when missing.
    - Remove tb/run_smx_exp2.sh, replaced by make regress.
    - smx_exp2: 0 mismatches at N_SEG = 4/8/16 (ModelSim ASE 10.5b);
    syn/map_check.sh passes. No Fitter or Fmax numbers yet.
    - docs/KNOWLEDGE.md: document the flow, fix stale block status.
2026-11-03 Add cross-block contract and shared infrastructure for remaining blocks
    - docs/spec/cross-block.md: ports, pipeline alignment, FSM, CYCLE_CNT,
    reviewed against a cycle model and Quartus probes
    - docs/spec/open-decisions.md: decisions awaiting Chau, and those taken
    - smx_pkg: block latencies, ROW_OVERHEAD, DM_W, SUM_W = 25
    - softmax_ref: expose intermediates, split group_sum, reciprocal,
    norm_out; arithmetic unchanged, checked on 6000 rows
    - sim, gen_vectors, map_check: sweep P, per-block vec_<block>.py
    - smx_delay: data delay helper
2026-11-03 Add smx_sumacc: 2-stage adder tree + accumulate, testbench, vectors, doc
2026-11-03 Add smx_maxtree: 2-stage signed max tree with running M and dM, testbench, vectors, block doc
2026-11-03 Add smx_csr: CSR file, acc_* decode and two-stage read path
2026-11-03 Add smx_core top: wiring, sideband, testbench, vectors, doc
2026-11-04 Harden tb_smx_core against test escapes, add syn/fit.sh
    An independent review found mutations the bench missed: bus reads during
    BUSY stealing the X_BUF address, and lost Y_BUF writes after a reset or a
    restart, hidden because the rerun used the same data as the stale Y_BUF.
    - Random bus traffic in BUSY cycles: reads checked at latency 2, and writes
    that must be ignored, read back after the run
    - Partner runs with the same rows and another K, so stale Y cannot pass
    - Passive count of Y_BUF writes for a restart in the first DONE cycle
    - Vectors: every L in 1..512, sum at 2^14, dM = 254 at each group position,
    one-hot at each position of short rows
    make regress passes at P, N_SEG = 4/8/1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
    [tb_smx_core.sv]
2026-11-05 Add PROGRESS.md so new sessions know what is next
    It records the current state, what is waiting on Chau and on the other teams,
    the next steps, and operational notes. KNOWLEDGE.md points to it first.
2026-11-05 Add diagram rules: orthogonal schematics instead of Mermaid
    Block diagrams now follow IC paper style: square boxes, straight wires with
    right-angle bends, labels beside the wires. docs/spec/fig/schematic.py draws
    hand-placed SVG and refuses a figure with a diagonal wire, overlapping wires,
    a wire through a box, a label on a wire, or an off-grid point.
    Mermaid flowcharts cannot meet this: with look: classic the bends are square,
    but auto layout runs wires on top of each other. fig/smx_core.svg is the sample
    and replaces the diagram in design-spec section 2.2. Older diagrams not migrated.
2026-11-05 Move all structure and FSM diagrams to orthogonal figures
    Replace every Mermaid flowchart and state diagram under docs/spec with
    hand-placed SVG from docs/spec/fig, 13 figures in all. Add a rule: wires in
    architecture diagrams carry bit ranges such as addr[15:0], given at P = 8,
    N_SEG = 8. The checker now also rejects a label on a hierarchy boundary.
2026-11-06 Number docs/spec files in reading order and update references
    Rename the top-level spec files to 01..09 (06 is blocks/) and fix every
    reference in docs, RTL/testbench comments and scripts.
    [smx_buf.sv, smx_core.sv, smx_csr.sv, smx_ctrl.sv, smx_divider.sv, smx_pkg.sv, tb_smx_csr.sv]
2026-11-06 Rewrite README for handoff and track CLAUDE.md and Claude commands
    README now states current status, the report/DV/board work streams, reading
    order and repo layout. CLAUDE.md and .claude/commands/ move onto git so the
    next owner's Claude sessions load them; CLAUDE.md gains a roles section.
    Local permissions (.claude/settings.json) and worktrees stay ignored.
2026-11-07 Add Quartus projects, Avalon wrapper and DE10 demo system with .sof builds
    - syn/smx.*: Quartus project for smx_core alone (P = 8, N_SEG = 8), compiles clean.
    - rtl/avalon/smx_avalon.sv, ip/smx_hw.tcl: thin Avalon-MM wrapper and Platform Designer component.
    - syn/de10/: JTAG-master + smx Platform Designer system, DE10-Standard top, pins, SDC, build.sh.
    - syn/release/: smx_core.sof and smx_de10.sof; .gitignore allows only these two .sof files.
    - Pin locations come from a third-party table and are not yet checked against the Terasic manual.
    - Not yet loaded on a board.
2026-11-11 Add DV environment and sanity test for smx_core
    BFM for the acc_* port, a scoreboard that streams golden vectors, a shared
    environment with the software sequence, and tb_smx_dv_sanity. Constants come
    from the requirements, not from smx_pkg. Vectors are generated through the
    existing sim flow by model/vec_dv_sanity.py.
    Claude-Session: https://claude.ai/code/session_018kvwhv1bCpue8SrQ4bVph8
2026-11-11 Add sim/setup.sh to point the sim flow at ModelSim
    Sourced once per terminal; finds the ModelSim folder (MODELSIM_DIR, the usual
    Intel install paths under WSL or Linux, or PATH) and exports vlib, vmap, vlog
    and vsim for sim/Makefile.
    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
2026-11-11 Print which modelsim.ini setup.sh will use, and warn when there is none
    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
2026-11-11 Add the remaining DV tests, the REQ-VER-03 checker and a suite target
    tb_smx_dv_ver02 (REQ-VER-02 matrix with self-checked coverage and hostile
    tails), tb_smx_dv_proto (bad START, START while BUSY, writes while BUSY),
    tb_smx_dv_latency (CYCLE_CNT against the spec formula), tb_smx_dv_reg (byte
    enables, undefined addresses, element-wise X_BUF writes) and tb_smx_dv_random
    (two passes, reset in mid-run). smx_core_chk is bound into the DUT and judges
    the status and read protocol every cycle. sim/Makefile gains 'make dv' and a
    SEED variable.
    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
    [smx_core_bind.sv, smx_core_chk.sv, smx_dv_env.sv, smx_dv_pkg.sv, smx_scoreboard.sv, tb_smx_dv_latency.sv, tb_smx_dv_proto.sv, tb_smx_dv_random.sv]
2026-11-12 Write the verification results into report chapter 6
    Environment, the six DV tests, ModelSim results at P = N_SEG = 8 and across
    the parameter sweep, the mutation check, requirement traceability and the
    limits of the results. Chapter 7 gets the simulated row latency. main.tex
    loads amsmath, which chapter 2 already needed to compile.
    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
2026-11-12 Revise the report: Vietnamese labels, current results, wording
    main.tex gets a language switch for the generated labels (Bảng, Hình, Mục
    lục, Tài liệu tham khảo, Chương; Table and so on for an English edition).
    Chapters 5, 7 and 8 now state what exists: all blocks integrated, Fitter
    resources and Fmax from the design spec, the P sweep. Chapter 3 gets the
    missing floor in the output formula. The bibliography matches the survey.
    Wording is tightened throughout and no line overflows the margin.
    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
2026-11-12 Describe the Avalon wrapper and DE10 demo system in the report; add a DV wave view
    Chapters 1, 4, 6, 7 and 8 now state what the implementation group has on its
    open branch: the smx_avalon wrapper, the Platform Designer component and the
    DE10 demo system compile, but have not run on the board. sim/Makefile gets
    'make dvview', which logs the DUT ports and the checker of one DV test and
    opens them in the ModelSim GUI with wave_dv.do.
    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
2026-11-12 Put the university, the group members and a logo slot on the report cover
    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
2026-11-12 Add tb_smx_dv_corner: sum bounds, largest max jump, every row length
    Vectors put the row sum at 2^14 (Rcp at its 27-bit maximum) and at 2^24, move
    the running maximum by 254 in each later group, and sweep L from 1 to L_MAX.
    The generator asserts the sums with the golden model; the test checks row
    shapes and fails on a missing scenario or length. A dropped top bit of Rcp
    passes tb_smx_dv_ver02 and is caught here.
    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
    [tb_smx_dv_corner.sv]
2026-11-12 Report the corner test: ModelSim result, log, mutation 13, traceability
    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
2026-11-13 Put the design diagrams into report chapters 4 and 5
    The 14 diagrams of docs/spec/fig are converted to PDF by
    docs/report/tools/svg2pdf.py. Chapter 4 gets the system boundary, the
    arithmetic flow, the inside of smx_core and the control FSM, with a short
    description of each; chapter 5 gets one diagram per block.
    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
2026-11-14 Start every report chapter on a new page and tighten the contents
    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
2026-11-14 Reduce white space in the report layout
    A chapter starts a new page only when less than half of the current page is
    left; otherwise it continues after a wide gap. Lists are tighter, floats may
    share a page with text and float-only pages fill from the top, and the short
    reference list follows the last chapter.
    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
